shamilajeewantha/fluid-pendant/specs/001-multi-stage-fluid-sim/checklists/requirements.md

# Specification Quality Checklist: Multi-Stage Fluid Simulation Pendant

**Purpose**: Validate specification completeness and quality before proceeding to planning
**Created**: 2026-06-21
**Feature**: [spec.md](../spec.md)

## Content Quality

- [x] No implementation details (languages, frameworks, APIs)
- [x] Focused on user value and business needs
- [x] Written for non-technical stakeholders
- [x] All mandatory sections completed

## Requirement Completeness

- [x] No [NEEDS CLARIFICATION] markers remain
- [x] Requirements are testable and unambiguous
- [x] Success criteria are measurable
- [x] Success criteria are technology-agnostic (no implementation details)
- [x] All acceptance scenarios are defined
- [x] Edge cases are identified
- [x] Scope is clearly bounded
- [x] Dependencies and assumptions identified

## Feature Readiness

- [x] All functional requirements have clear acceptance criteria
- [x] User scenarios cover primary flows
- [x] Feature meets measurable outcomes defined in Success Criteria
- [x] No implementation details leak into specification

## Notes

- Items marked incomplete require spec updates before `/speckit-clarify` or `/speckit-plan`.
- No [NEEDS CLARIFICATION] markers were needed: the project's existing constitution (`.specify/memory/constitution.md`) and prior codebase (existing C simulation source, existing accelerometer/LED-matrix sample projects) already fix the hardware-level facts (target MCU, accelerometer, charlieplexed display) that would otherwise require clarification. Reasonable defaults for remaining ambiguities are documented in the Assumptions section.
