shamilajeewantha/fluid-pendant/media/photos/altium/pcb_3d_angled.png

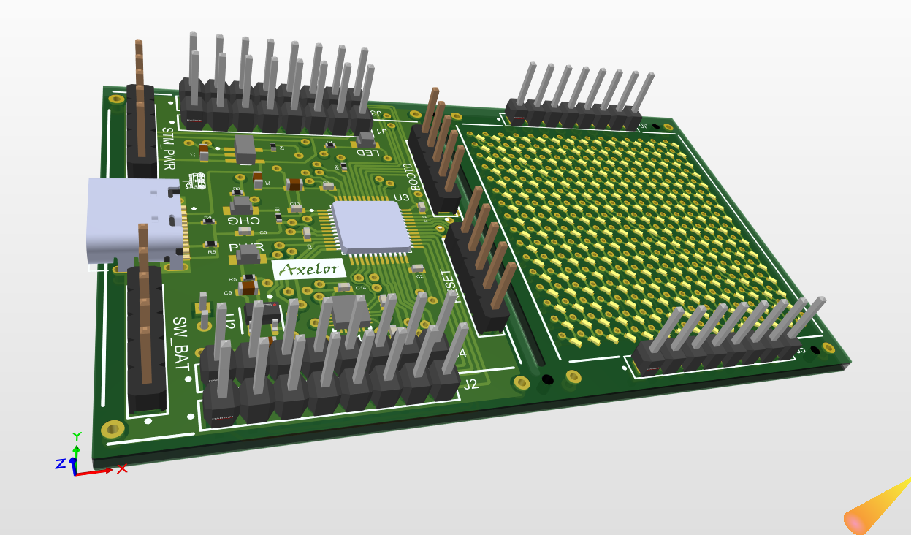
media/photos/altium/pcb_3d_angled.png
