shamilajeewantha/fluid-pendant/media/photos/pcb/axelor5.jpg

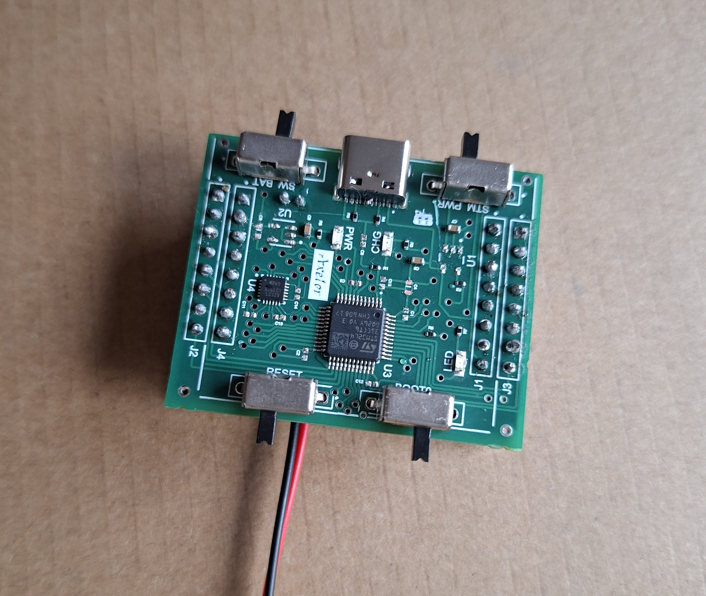
media/photos/pcb/axelor5.jpg
