shamilajeewantha/fluid-pendant/media/photos/pcb/axelor6.jpg

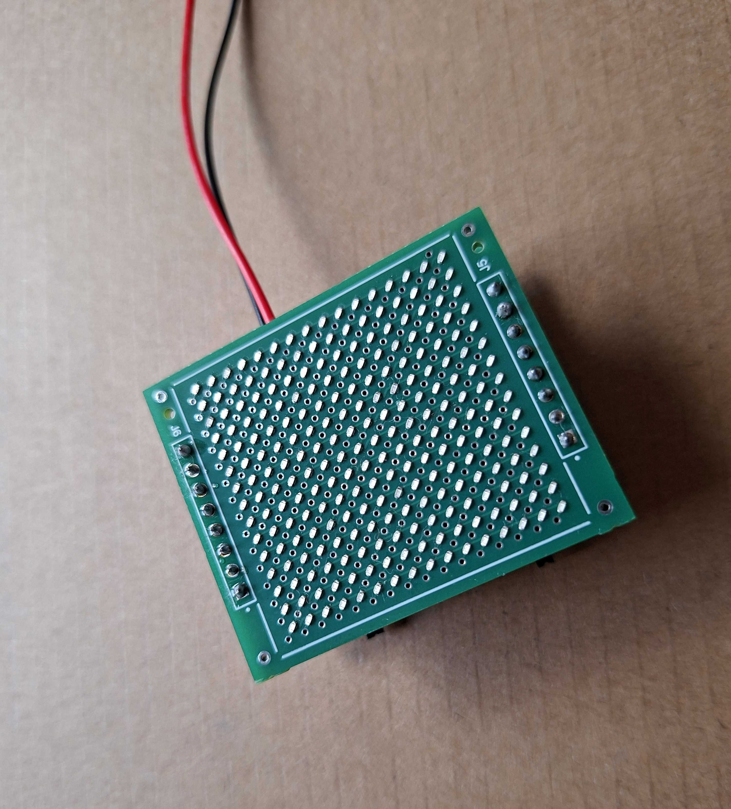
media/photos/pcb/axelor6.jpg
