shamilajeewantha/fluid-pendant/media/photos/pcb/axelor8.jpg

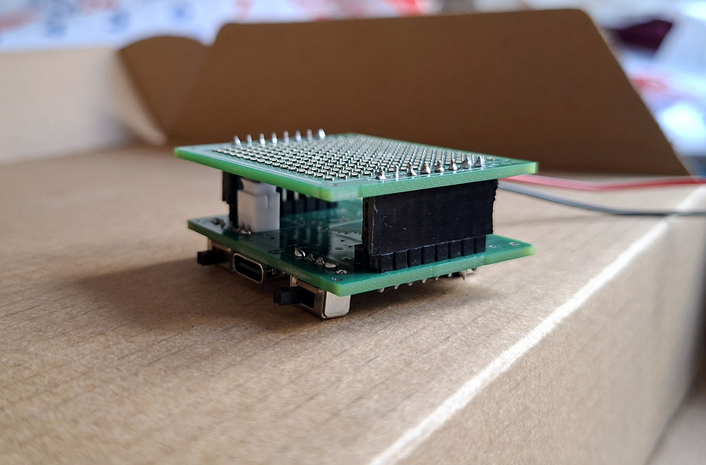
media/photos/pcb/axelor8.jpg
