shamilajeewantha/fluid-pendant/media/photos/pcb/axelor10.jpg

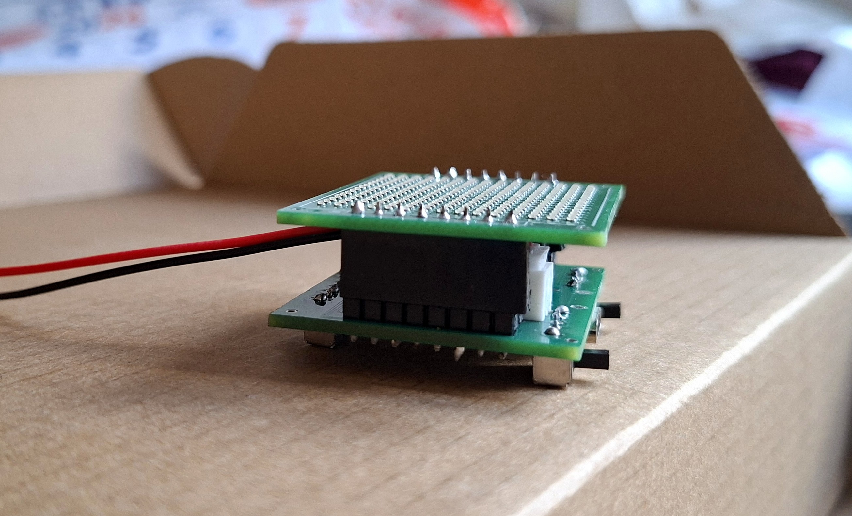
media/photos/pcb/axelor10.jpg
