shamilajeewantha/fluid-pendant/media/photos/pcb/axelor11.jpg

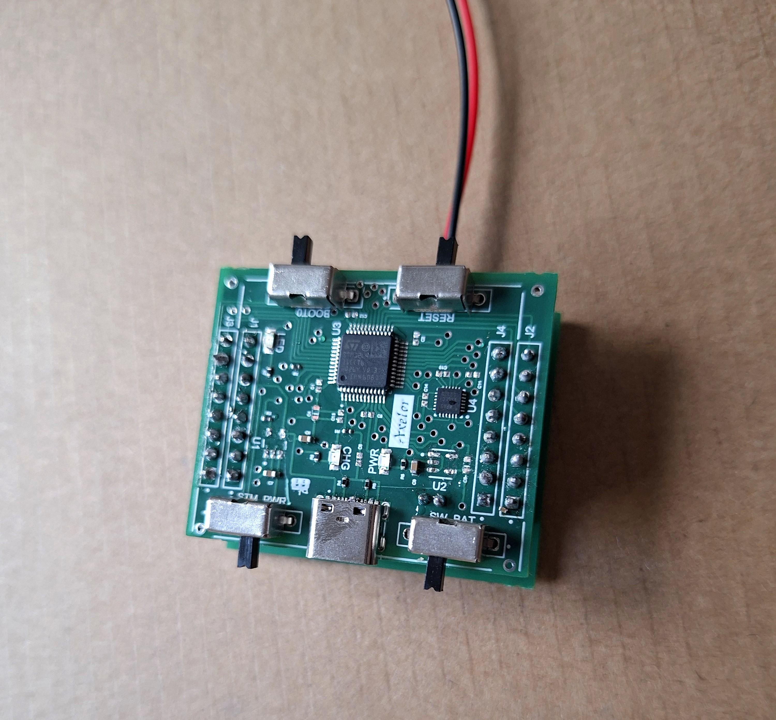
media/photos/pcb/axelor11.jpg
