shamilajeewantha/fluid-pendant/media/photos/pcb/axelor12.jpg

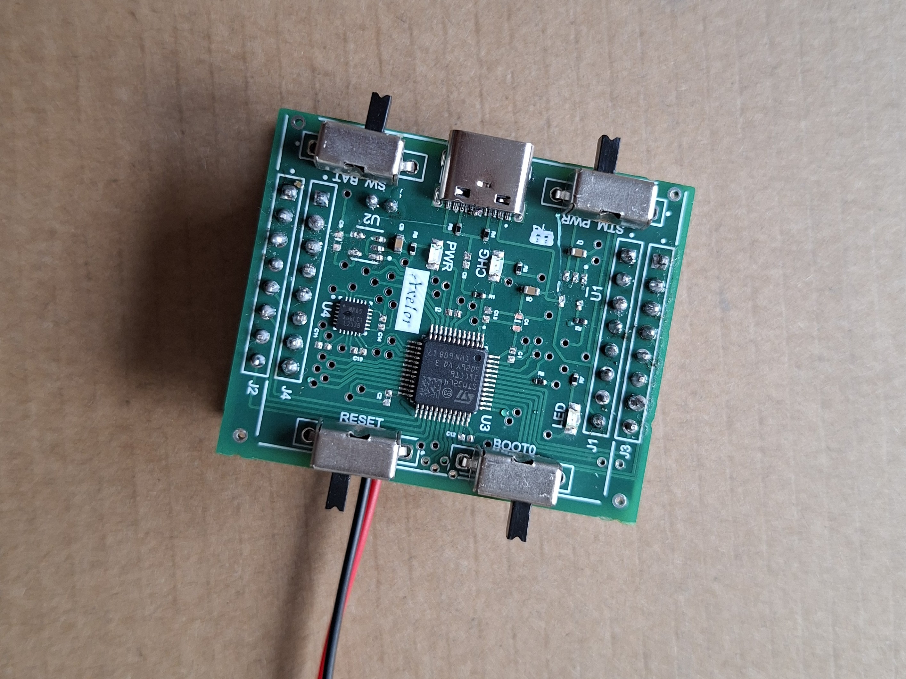
media/photos/pcb/axelor12.jpg
