shamilajeewantha/fluid-pendant/media/photos/pcb/axelor13.jpg

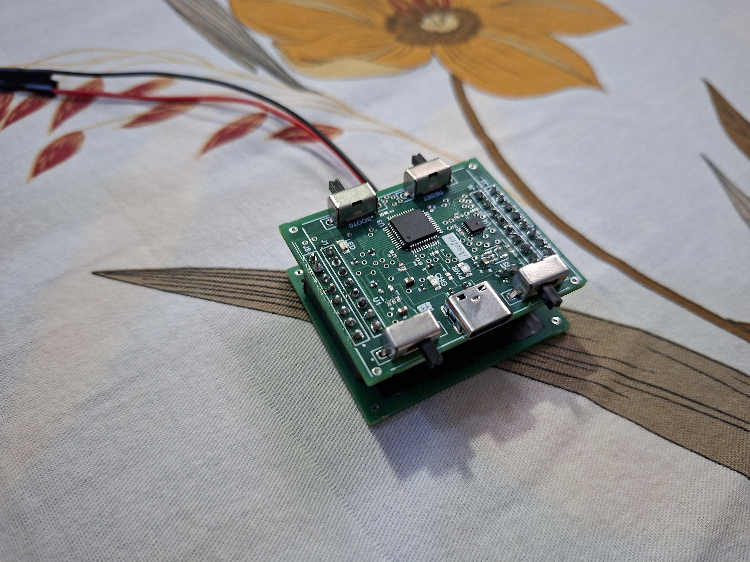
media/photos/pcb/axelor13.jpg
