shamilajeewantha/fluid-pendant/media/photos/pcb/loose_connections.jpg

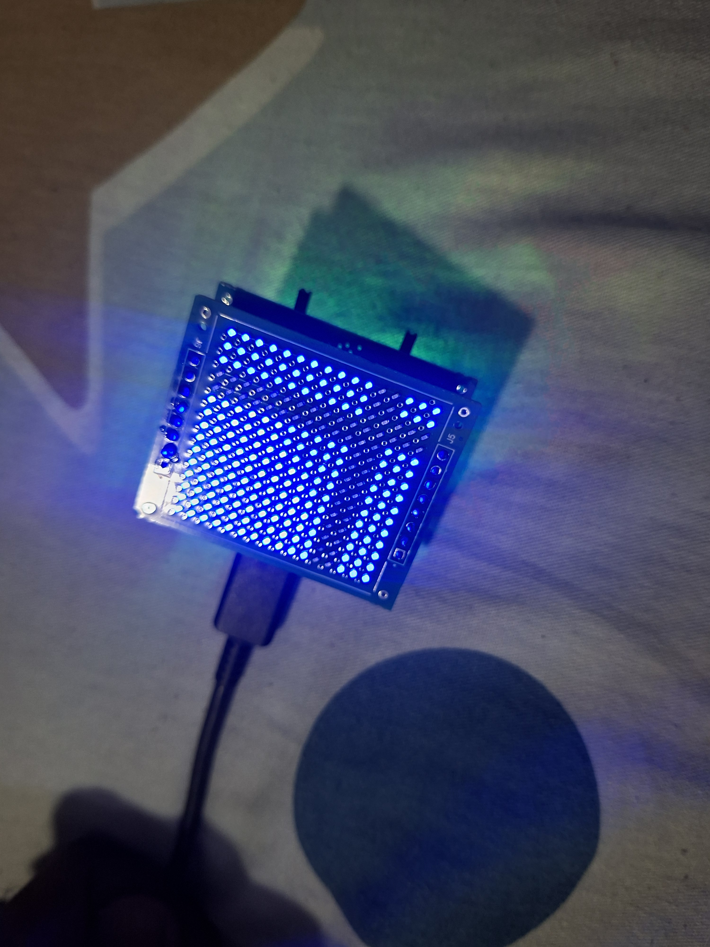
media/photos/pcb/loose_connections.jpg
