shamilajeewantha/fluid-pendant/media/photos/pcb/two_pieces.jpg

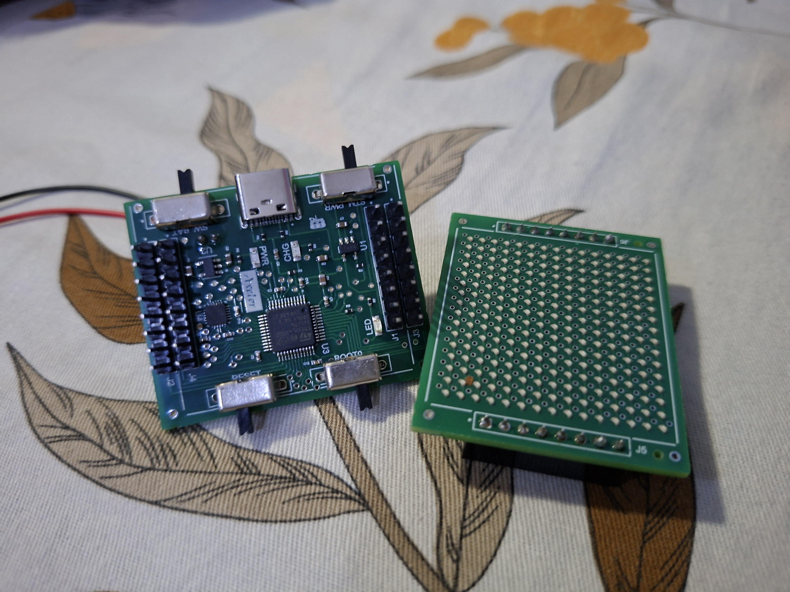
media/photos/pcb/two_pieces.jpg
