shamilajeewantha/fluid-pendant/stm_project/axelor/Core/Src/main.c

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
/* Includes ------------------------------------------------------------------*/
#include "main.h"

/* USER CODE BEGIN Includes */
#include <stdio.h>
#include <string.h>
#include "scene.h"
#include "flip_utils.h"
/* USER CODE END Includes */

SPI_HandleTypeDef hspi1;

TIM_HandleTypeDef htim1;
DMA_HandleTypeDef hdma_tim1_up;
DMA_HandleTypeDef hdma_tim1_ch1;

UART_HandleTypeDef huart1;

/* USER CODE BEGIN PV */

uint32_t blinkCounter = 0;
char msg[128];

/* Charlieplex hardware bring-up scan. This board has NO per-leg current-limiting
   resistors on PB0..PB15 (confirmed), so the only thing protecting the GPIO pins
   from a software bug is the software itself -- see ChargePlex_ValidateScanTable
   and ChargePlex_CheckAlive below. */
#define CP_PIN_COUNT  16
#define CP_SLOT_COUNT (CP_PIN_COUNT * (CP_PIN_COUNT - 1)) /* 240: every ordered (src,dst) pin pair */

/* This board's wiring (confirmed by user): each of the 16 PB pins takes a turn as one row's
   single source/driving pin, with the other 15 pins as that row's sink/column pins -- the
   standard charlieplex row/column convention. ChargePlex_BuildScanTable's enumeration order
   (outer loop over src, inner loop over dst) already groups slots into exactly CP_ROWS
   contiguous blocks of CP_COLS slots each as a direct result -- row r occupies slots
   [r*CP_COLS, r*CP_COLS + CP_COLS - 1]. */
#define CP_ROWS CP_PIN_COUNT       /* 16 */
#define CP_COLS (CP_PIN_COUNT - 1) /* 15 */

static uint32_t bsrr_buf[CP_SLOT_COUNT];
static uint32_t moder_buf[CP_SLOT_COUNT];
static volatile uint8_t chargePlexFaulted = 0;
static uint8_t chargePlexFaultReported = 0;

/* Set true only after HAL_DMA_Start has actually run on both channels in main(), below.
   SysTick (and therefore ChargePlex_CheckAlive, which it calls every 1ms) starts running at
   HAL_Init(), several peripheral inits before MX_TIM1_Init() gives hdma_tim1_up/ch1 a real
   .Instance (set inside HAL_TIM_Base_MspInit, stm32l4xx_hal_msp.c). Without this guard,
   ChargePlex_CheckAlive reads __HAL_DMA_GET_COUNTER on a NULL .Instance during that gap --
   garbage memory, not a real transfer counter -- and a false "stalled" reading there
   permanently latches chargePlexFaulted before the real scan table even exists, silently
   disabling this watchdog for the rest of the session. */
static volatile uint8_t chargePlexScanStarted = 0;

/* Immutable per-slot "this is what moder_buf[slot] would be if this slot is on" reference,
   filled once by ChargePlex_BuildScanTable and never modified afterward -- moder_buf itself
   gets zeroed for "off" slots every frame, so this is what lets a slot be safely turned back
   on later without losing its source/sink pin-pair identity. */
static uint32_t moder_template[CP_SLOT_COUNT];

/* Firmware-local stand-in for DisplayFrame/cellColor until the physics core is ported
   onto this board (research.md Decision 17, data-model.md AxelorFrameBuffer). Shaped as an
   actual [row][col] matrix (not a flat 240 array) to match the eventual real DisplayFrame/
   cellColor shape directly -- no flattening will be needed when that swap happens. Filled by
   a placeholder pattern generator for now; NOT read by DMA -- only ChargePlex_ApplyFrameBuffer()
   translates it into moder_buf (via the row/col -> slot formula above), and only after
   re-validating. The DMA scanner, bsrr_buf, moder_template, and the validator are untouched by
   this -- this buffer is purely upstream of ChargePlex_ApplyFrameBuffer's existing gate. */
static uint8_t cpFrameBuf[CP_ROWS][CP_COLS];
static uint32_t cpCandidateModer[CP_SLOT_COUNT];

/* Round 9: the real ported FLIP simulation driving cpFrameBuf above, in place of Round 8's
   placeholder pattern generator (research.md Decisions 21-24). */
static Scene axelorScene;

/* MPU-6500's own +/-2g full-scale range (spec.md Clarifications Session 2026-06-23;
   research.md Decision 22) -- clamps accelX_mps2/accelY_mps2 before they reach
   simulateFlipFluid, so a violent shake can't inject an unbounded force into the solver. */
#define MAX_GRAVITY_MPS2 19.62f

static inline float ClampGravityMps2(float v)
{
    if (v > MAX_GRAVITY_MPS2) return MAX_GRAVITY_MPS2;
    if (v < -MAX_GRAVITY_MPS2) return -MAX_GRAVITY_MPS2;
    return v;
}

/* Round 11: dt is now this tick's measured wall-clock time (HAL_GetTick(), 1ms resolution), not a
   fixed 0.02f -- the loop no longer sleeps a fixed amount, so a fixed dt would drift from real
   time by whatever the tick's compute happened to cost (research.md Round 11). Clamped so the
   solver stays stable if a tick stalls, and to avoid dt<=0 if two ticks land in the same ms. */
#define MIN_DT_S 0.001f
#define MAX_DT_S 0.04f

static inline float ClampDtS(float v)
{
    if (v < MIN_DT_S) return MIN_DT_S;
    if (v > MAX_DT_S) return MAX_DT_S;
    return v;
}

/* Shared by the Counter print and MPU6500_ReadAccel's own prints below. Round 11: switched from
   iteration-count throttling (printTick % 25, tuned for the old fixed ~20ms/iteration) to
   elapsed-time throttling, since the loop no longer has a fixed period -- recomputed once per
   loop iteration, before MPU6500_ReadAccel() is called. */
static uint32_t lastPrintMs = 0;
static uint8_t printGate = 0;

/* USER CODE END PV */

void SystemClock_Config(void);
static void MX_GPIO_Init(void);
static void MX_DMA_Init(void);
static void MX_SPI1_Init(void);
static void MX_USART1_UART_Init(void);
static void MX_TIM1_Init(void);
/* USER CODE BEGIN 0 */

/* Retargets newlib's printf to huart1. Without this, syscalls.c's _write falls through to a
   weak, undefined __io_putchar -- harmless as long as nothing calls printf, but flip_utils.c's
   setupScene() (ported as-is from the canonical physics source, research.md Decision 18) does
   call printf once at boot, which would otherwise jump to an unresolved address and HardFault
   the very first time the simulation is set up. */
int __io_putchar(int ch)
{
    HAL_UART_Transmit(&huart1, (uint8_t*)&ch, 1, HAL_MAX_DELAY);
    return ch;
}

uint8_t mpuTxData[2];
uint8_t mpuRxData[2];

void MPU6500_ReadWhoAmI(void)
{
    uint8_t whoami;
    HAL_StatusTypeDef status;

    sprintf(msg, "[MPU] Starting WHO_AM_I read...\r\n");
    HAL_UART_Transmit(&huart1, (uint8_t*)msg, strlen(msg), HAL_MAX_DELAY);

    sprintf(msg, "[MPU] CS (PA5) -> LOW\r\n");
    HAL_UART_Transmit(&huart1, (uint8_t*)msg, strlen(msg), HAL_MAX_DELAY);
    HAL_GPIO_WritePin(GPIOA, GPIO_PIN_5, GPIO_PIN_RESET); // CS low

    mpuTxData[0] = 0x75 | 0x80; // WHO_AM_I register (0x75), read bit set
    mpuTxData[1] = 0x00;        // dummy byte to receive data

    status = HAL_SPI_TransmitReceive(&hspi1, mpuTxData, mpuRxData, 2, HAL_MAX_DELAY);

    HAL_GPIO_WritePin(GPIOA, GPIO_PIN_5, GPIO_PIN_SET); // CS high

    /* Snapshot results immediately, before any sprintf can touch these buffers */
    uint8_t tx0 = mpuTxData[0], tx1 = mpuTxData[1];
    uint8_t rx0 = mpuRxData[0], rx1 = mpuRxData[1];
    whoami = rx1;

    sprintf(msg, "[MPU] CS (PA5) -> HIGH\r\n");
    HAL_UART_Transmit(&huart1, (uint8_t*)msg, strlen(msg), HAL_MAX_DELAY);

    sprintf(msg, "[MPU] HAL_SPI_TransmitReceive status: %d (0=OK,1=ERROR,2=BUSY,3=TIMEOUT)\r\n", status);
    HAL_UART_Transmit(&huart1, (uint8_t*)msg, strlen(msg), HAL_MAX_DELAY);

    sprintf(msg, "[MPU] tx=[0x%02X 0x%02X] rx=[0x%02X 0x%02X]\r\n", tx0, tx1, rx0, rx1);
    HAL_UART_Transmit(&huart1, (uint8_t*)msg, strlen(msg), HAL_MAX_DELAY);

    sprintf(msg, "[MPU] WHO_AM_I: 0x%02X (expect 0x70) -> %s\r\n",
            whoami, (whoami == 0x70) ? "PASS" : "FAIL");
    HAL_UART_Transmit(&huart1, (uint8_t*)msg, strlen(msg), HAL_MAX_DELAY);
}

void MPU6500_WriteReg(uint8_t reg, uint8_t value)
{
    uint8_t tx[2] = { (uint8_t)(reg & 0x7F), value }; // write: MSB of addr = 0
    uint8_t rx[2];

    HAL_GPIO_WritePin(GPIOA, GPIO_PIN_5, GPIO_PIN_RESET);
    HAL_SPI_TransmitReceive(&hspi1, tx, rx, 2, HAL_MAX_DELAY);
    HAL_GPIO_WritePin(GPIOA, GPIO_PIN_5, GPIO_PIN_SET);
}

void MPU6500_ReadRegs(uint8_t reg, uint8_t *buf, uint8_t len)
{
    uint8_t tx[8] = {0};
    uint8_t rx[8] = {0};

    tx[0] = reg | 0x80; // read: MSB of addr = 1

    HAL_GPIO_WritePin(GPIOA, GPIO_PIN_5, GPIO_PIN_RESET);
    HAL_SPI_TransmitReceive(&hspi1, tx, rx, len + 1, HAL_MAX_DELAY);
    HAL_GPIO_WritePin(GPIOA, GPIO_PIN_5, GPIO_PIN_SET);

    memcpy(buf, &rx[1], len);
}

void MPU6500_Init(void)
{
    MPU6500_WriteReg(0x6A, 0x10); // USER_CTRL: I2C_IF_DIS = 1, lock to SPI-only mode
    HAL_Delay(1);
    MPU6500_WriteReg(0x6B, 0x01); // PWR_MGMT_1: clear SLEEP, select PLL clock source
    HAL_Delay(10);
    MPU6500_WriteReg(0x1C, 0x00); // ACCEL_CONFIG: AFS_SEL = 0 -> +/-2g, 16384 LSB/g

    sprintf(msg, "[MPU] Init done: SPI-only, awake, accel range +/-2g\r\n");
    HAL_UART_Transmit(&huart1, (uint8_t*)msg, strlen(msg), HAL_MAX_DELAY);
}

uint8_t accelRaw[6];
int16_t accelX_raw, accelY_raw, accelZ_raw;
/* Round 9: promoted from MPU6500_ReadAccel's locals to file scope so main()'s loop can read
   this tick's value as the simulation's gravity input after this function returns (research.md
   Decision 16/22). */
float accelX_mps2, accelY_mps2, accelZ_mps2;

void MPU6500_ReadAccel(void)
{
    MPU6500_ReadRegs(0x3B, accelRaw, 6); // ACCEL_XOUT_H..ACCEL_ZOUT_L

    accelX_raw = (int16_t)((accelRaw[0] << 8) | accelRaw[1]);
    accelY_raw = (int16_t)((accelRaw[2] << 8) | accelRaw[3]);
    accelZ_raw = (int16_t)((accelRaw[4] << 8) | accelRaw[5]);

    // milli-g via integer math (avoids needing float-in-printf support)
    long accelX_mg = ((long)accelX_raw * 1000) / 16384;
    long accelY_mg = ((long)accelY_raw * 1000) / 16384;
    long accelZ_mg = ((long)accelZ_raw * 1000) / 16384;

    if (printGate)
    {
        sprintf(msg, "[ACCEL] raw=[%d %d %d] mg=[%ld %ld %ld]\r\n",
                accelX_raw, accelY_raw, accelZ_raw, accelX_mg, accelY_mg, accelZ_mg);
        HAL_UART_Transmit(&huart1, (uint8_t*)msg, strlen(msg), HAL_MAX_DELAY);
    }

    // m/s^2 -- the exact unit/scale MotionInput.x/y and Scene.gravity_x/y need (research.md
    // Decision 16). Round 9: this now IS read, as the simulation's gravity input (clamped in
    // main()'s loop before reaching simulateFlipFluid, research.md Decision 22).
    accelX_mps2 = (accelX_mg / 1000.0f) * 9.81f;
    accelY_mps2 = (accelY_mg / 1000.0f) * 9.81f;
    accelZ_mps2 = (accelZ_mg / 1000.0f) * 9.81f;

    if (printGate)
    {
        // Printed as milli-(m/s^2) integers, same float-in-printf avoidance as the mg line above --
        // the underlying accel*_mps2 floats are the real value driving the simulation; only the
        // *display* stays integer-only.
        long accelX_mmps2 = (long)(accelX_mps2 * 1000.0f);
        long accelY_mmps2 = (long)(accelY_mps2 * 1000.0f);
        long accelZ_mmps2 = (long)(accelZ_mps2 * 1000.0f);

        sprintf(msg, "[ACCEL] mm/s2=[%ld %ld %ld] (= m/s2 x1000; sim will want this unit/scale)\r\n",
                accelX_mmps2, accelY_mmps2, accelZ_mmps2);
        HAL_UART_Transmit(&huart1, (uint8_t*)msg, strlen(msg), HAL_MAX_DELAY);
    }
}

/* Fills bsrr_buf/moder_buf with every one of the 240 ordered (source,sink) pin
   pairs on PB0..PB15, generated from the charlieplex formula instead of hand-typed
   hex -- a transcription error in a 240-entry literal table is exactly the kind of
   mistake that, on this resistor-less board, could drive two pins into each other.
   Bit-pattern verified by hand against the working 3-pin proof of concept in
   stm_projects/sample-charlieplexing (e.g. its LED1 = PB0 source/PB6 sink encodes
   to moder=0x00001001/bsrr=0x00400001, which this formula reproduces exactly for
   src=0,dst=6). */
static void ChargePlex_BuildScanTable(void)
{
    int slot = 0;
    for (int src = 0; src < CP_PIN_COUNT; src++)
    {
        for (int dst = 0; dst < CP_PIN_COUNT; dst++)
        {
            if (src == dst) continue;
            bsrr_buf[slot]      = (1UL << src) | (1UL << (dst + 16));
            moder_template[slot] = (1UL << (src * 2)) | (1UL << (dst * 2));
            moder_buf[slot]      = moder_template[slot]; /* initial state: every slot on */
            slot++;
        }
    }
}

/* Confirms every one of the 240 slots is either a valid "on" slot (exactly one source
   pin high, one different sink pin low, every other pin plain input) or a valid "off"
   slot (every pin plain input, nothing driven) -- checked before MOE/DMA are ever
   enabled, and again before any regenerated frame buffer is allowed to replace the
   live moder_buf (research.md Decision 17), so a table bug fails safe (matrix doesn't
   start, or the previous known-good frame is kept) instead of silently energizing an
   unintended pin pair. */
static int ChargePlex_ValidateScanTable(const uint32_t *moderToCheck)
{
    for (int slot = 0; slot < CP_SLOT_COUNT; slot++)
    {
        uint32_t moder = moderToCheck[slot];
        uint32_t bsrr  = bsrr_buf[slot]; /* bsrr_buf never changes after boot -- only moder does */
        int outputCount = 0;
        int srcPin = -1, dstPin = -1;

        for (int pin = 0; pin < CP_PIN_COUNT; pin++)
        {
            uint32_t field  = (moder >> (pin * 2)) & 0x3UL;
            int      isSet  = (bsrr & (1UL << pin)) != 0;
            int      isReset = (bsrr & (1UL << (pin + 16))) != 0;

            if (field == 0x1) /* configured as output for this slot */
            {
                outputCount++;
                if (isReset)    dstPin = pin; /* RESET has priority over SET in BSRR on real silicon */
                else if (isSet) srcPin = pin;
                else            return 0; /* output pin with no defined level -- reject */
            }
            else if (field != 0x0)
            {
                return 0; /* AF/analog should never appear in this table -- reject */
            }
            /* field == 0x0 (input): nothing to check. bsrr_buf is immutable and permanently
               holds this slot's 2 designated pins regardless of whether this slot is currently
               on or off -- an input pin is electrically disconnected from BSRR/ODR at the
               hardware level, so a "set"/"reset" bit sitting there for an off slot is the
               expected, harmless resting state, not a defect (this was incorrectly rejected
               before Round 8's off-slot support was added, which made every off slot fail). */
        }

        if (outputCount == 0)
        {
            continue; /* valid "off" slot -- nothing driven this cycle (research.md Decision 17) */
        }
        if (outputCount != 2 || srcPin < 0 || dstPin < 0 || srcPin == dstPin)
            return 0;
    }
    return 1;
}

/* Translates cpFrameBuf into a candidate moder_buf (on slots get their immutable
   moder_template pattern back; off slots get 0/all-input), validates that candidate in
   full, and only then commits it over the live moder_buf -- exactly the same fail-safe
   shape as the boot-time check, applied to every regenerated frame (research.md Decision
   17). A rejected frame is not a stall (the existing scan is still known-good and keeps
   running); it just means this particular new frame didn't pass and is discarded. */
static void ChargePlex_ApplyFrameBuffer(void)
{
    for (int row = 0; row < CP_ROWS; row++)
    {
        for (int col = 0; col < CP_COLS; col++)
        {
            int slot = row * CP_COLS + col; /* matches ChargePlex_BuildScanTable's row-major (src,dst) enumeration exactly */
            cpCandidateModer[slot] = cpFrameBuf[row][col] ? moder_template[slot] : 0;
        }
    }

    if (ChargePlex_ValidateScanTable(cpCandidateModer))
    {
        memcpy(moder_buf, cpCandidateModer, sizeof(moder_buf));
    }
    else
    {
        sprintf(msg, "[CHARLIEPLEX] frame rejected, keeping previous frame\r\n");
        HAL_UART_Transmit(&huart1, (uint8_t*)msg, strlen(msg), HAL_MAX_DELAY);
    }
}

/* Drives every PB pin back to plain input (HiZ) directly via register write,
   bypassing TIM1/DMA entirely. Deliberately avoids any HAL call that polls against
   HAL_GetTick() (e.g. HAL_DMA_Abort) -- this can be invoked from SysTick_Handler
   itself, where the tick is not advancing, so any such call would spin forever
   instead of completing. */
static void ChargePlex_ForceSafeState(void)
{
    __HAL_TIM_MOE_DISABLE(&htim1);
    __HAL_TIM_DISABLE(&htim1);
    hdma_tim1_up.Instance->CCR  &= ~DMA_CCR_EN;
    hdma_tim1_ch1.Instance->CCR &= ~DMA_CCR_EN;
    GPIOB->MODER = 0x00000000;
}

/* Called every 1ms from SysTick_Handler (stm32l4xx_it.c) so stall-detection latency
   never depends on whatever the main loop happens to be blocked in (HAL_Delay,
   blocking UART/SPI transfers, etc). Compares each DMA channel's remaining-transfer
   counter against the value read on the *previous* 1ms tick: at the real scan rate
   (~80MHz/2776 =~ 28.8 kHz/slot) the counter advances by roughly 28 of its 240
   states every millisecond, so an unchanged reading one tick later means the scan
   has stalled -- and with no series resistors on this board, a stalled scan means
   whatever pin pair was active is now driven continuously instead of multiplexed. */
void ChargePlex_CheckAlive(void)
{
    static uint32_t lastUp  = 0xFFFFFFFFUL; /* sentinel: no prior sample yet */
    static uint32_t lastCh1 = 0xFFFFFFFFUL;

    if (chargePlexFaulted || !chargePlexScanStarted) return;

    uint32_t up  = __HAL_DMA_GET_COUNTER(&hdma_tim1_up);
    uint32_t ch1 = __HAL_DMA_GET_COUNTER(&hdma_tim1_ch1);

    if (lastUp != 0xFFFFFFFFUL && (up == lastUp || ch1 == lastCh1))
    {
        chargePlexFaulted = 1;
        ChargePlex_ForceSafeState();
    }

    lastUp  = up;
    lastCh1 = ch1;
}
/* USER CODE END 0 */

/**
  * @brief  The application entry point.
  * @retval int
  */
int main(void)
{

  /* MCU Configuration--------------------------------------------------------*/

  /* Reset of all peripherals, Initializes the Flash interface and the Systick. */
  HAL_Init();

  /* Configure the system clock */
  SystemClock_Config();

  /* Initialize all configured peripherals */
  MX_GPIO_Init();
  MX_DMA_Init();
  MX_SPI1_Init();
  MX_USART1_UART_Init();
  MX_TIM1_Init();
  /* USER CODE BEGIN 2 */
  sprintf(msg, "\r\n>>> BUILD MARKER: AXELOR-001 <<<\r\n");
  HAL_UART_Transmit(&huart1, (uint8_t*)msg, strlen(msg), HAL_MAX_DELAY);

  HAL_Delay(100); // MPU-6500 register read/write start-up time
  MPU6500_ReadWhoAmI();
  MPU6500_Init();

  /* Round 9: bring up the real ported FLIP simulation before the matrix scan starts, so
     cpFrameBuf is never read by ChargePlex_ApplyFrameBuffer before it has real sim output to
     copy (research.md Decision 24). scene_init()/setupScene() are the unmodified, ported
     functions; paused is forced false only here, in this board-specific glue code -- there is
     no UI on this board to ever un-pause it otherwise. */
  scene_init(&axelorScene);
  setupScene(&axelorScene);
  axelorScene.paused = false;
  sprintf(msg, "[SIM] setup complete\r\n");
  HAL_UART_Transmit(&huart1, (uint8_t*)msg, strlen(msg), HAL_MAX_DELAY);

  ChargePlex_BuildScanTable();
  if (!ChargePlex_ValidateScanTable(moder_buf))
  {
      sprintf(msg, "[CHARLIEPLEX] FAULT: scan table failed self-check -- matrix NOT started\r\n");
      HAL_UART_Transmit(&huart1, (uint8_t*)msg, strlen(msg), HAL_MAX_DELAY);
      chargePlexFaulted = 1;
      chargePlexFaultReported = 1;
      ChargePlex_ForceSafeState(); /* belt-and-suspenders: PB pins should already be input from MX_GPIO_Init */
  }
  else
  {
      sprintf(msg, "[CHARLIEPLEX] scan table OK (240/240 slots), starting matrix scan\r\n");
      HAL_UART_Transmit(&huart1, (uint8_t*)msg, strlen(msg), HAL_MAX_DELAY);

      __HAL_TIM_MOE_ENABLE(&htim1);
      HAL_DMA_Start(&hdma_tim1_ch1, (uint32_t)bsrr_buf, (uint32_t)&GPIOB->BSRR, CP_SLOT_COUNT);
      HAL_DMA_Start(&hdma_tim1_up, (uint32_t)moder_buf, (uint32_t)&GPIOB->MODER, CP_SLOT_COUNT);
      HAL_TIM_OC_Start(&htim1, TIM_CHANNEL_1);
      __HAL_TIM_ENABLE_DMA(&htim1, TIM_DMA_CC1);
      __HAL_TIM_ENABLE_DMA(&htim1, TIM_DMA_UPDATE);
      HAL_TIM_Base_Start(&htim1);
      chargePlexScanStarted = 1; /* only now is it safe for ChargePlex_CheckAlive to read the DMA counters */
  }
  /* USER CODE END 2 */

  /* Round 11: tracks real elapsed time between ticks so dt can be measured instead of assumed
     (research.md Round 11). Initialized right before the loop starts, not at declaration, so the
     first iteration's delta is near-zero rather than however long boot took. */
  uint32_t lastTickMs = HAL_GetTick();

  /* Infinite loop */
  /* USER CODE BEGIN WHILE */
  while (1)
  {
    /* USER CODE END WHILE */

    /* USER CODE BEGIN 3 */
    /* Round 11: one HAL_GetTick() read serves both this tick's dt and the print-throttle gate --
       the loop no longer sleeps a fixed amount, so both must be measured, not assumed. */
    uint32_t nowMs = HAL_GetTick();
    float tickDt = ClampDtS((nowMs - lastTickMs) / 1000.0f);
    lastTickMs = nowMs;
    printGate = (nowMs - lastPrintMs) >= 500;
    if (printGate) lastPrintMs = nowMs;

    /* Read first so this tick's freshest accel sample drives this tick's simulation step
       below, rather than the previous tick's (research.md Decision 21/22). */
    MPU6500_ReadAccel();

    if (chargePlexFaulted && !chargePlexFaultReported)
    {
        sprintf(msg, "[CHARLIEPLEX] FAULT: scan stalled -- matrix forced to safe input state\r\n");
        HAL_UART_Transmit(&huart1, (uint8_t*)msg, strlen(msg), HAL_MAX_DELAY);
        chargePlexFaultReported = 1;
    }
    else if (!chargePlexFaulted)
    {
        /* Round 9: the real ported simulation replaces Round 8's placeholder pattern
           generator (research.md Decision 23). Gravity input is this tick's accel reading,
           magnitude-clamped to the MPU-6500's own +/-2g range (Decision 22) before reaching
           simulateFlipFluid -- the physics core itself stays an unmodified, verbatim port
           (contracts/physics-core.md), so the clamp lives here in board-specific glue code.
           Round 10: on-hardware testing found the board's mounted accelerometer axes are
           swapped relative to the display's row/col axes -- accelX_mps2 is physically the
           vertical (row) axis and accelY_mps2 is the horizontal (col) axis, not the other way
           around as originally assumed. gravity_y drives row motion and gravity_x drives col
           motion in simulateFlipFluid (see flip_fluid.c's dstY*GRID_X+dstX convention), so the
           accel axes are swapped here to match. */
        float clampedGravityX = ClampGravityMps2(accelY_mps2);
        float clampedGravityY = ClampGravityMps2(accelX_mps2);

        simulateFlipFluid(axelorScene.fluid, tickDt, clampedGravityX, clampedGravityY,
                           axelorScene.flipRatio, axelorScene.numPressureIters,
                           axelorScene.numParticleIters, axelorScene.overRelaxation,
                           axelorScene.compensateDrift, axelorScene.separateParticles);

        for (int row = 0; row < CP_ROWS; row++)
        {
            for (int col = 0; col < CP_COLS; col++)
            {
                cpFrameBuf[row][col] = (axelorScene.fluid->cellColor[row * GRID_X + col] > 0.5f) ? 1 : 0;
            }
        }

        /* Unmodified from Round 8 -- still the same validate-or-reject gate, applied to the
           real simulation's output exactly as it was to the placeholder pattern. */
        ChargePlex_ApplyFrameBuffer();
    }

    HAL_GPIO_TogglePin(GPIOC, GPIO_PIN_13);
    blinkCounter++;
    if (printGate)
    {
        sprintf(msg, "Counter: %lu\r\n", blinkCounter);
        HAL_UART_Transmit(&huart1, (uint8_t*)msg, strlen(msg), HAL_MAX_DELAY);
    }
    /* Round 11: no fixed delay -- loop runs at compute speed (research.md Round 11). Safe because
       ChargePlex's scan is TIM1+DMA-driven, decoupled from main-loop rate; this never changes
       what's written to cpFrameBuf or how often ChargePlex_ApplyFrameBuffer() is called per tick. */
  }
  /* USER CODE END 3 */
}

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
