shamilajeewantha/fluid-pendant/stm_project/axelor/axelor.ioc

Mcu.UserName=STM32L431CCTx
PA1.Signal=SPI1_SCK
PA10.Signal=USART1_RX
PA5.Signal=GPIO_Output
PA6.Signal=SPI1_MISO
PA7.Signal=SPI1_MOSI
PA9.Signal=USART1_TX
PB0.Signal=GPIO_Input
PB1.Signal=GPIO_Input
PB10.Signal=GPIO_Input
PB11.Signal=GPIO_Input
PB12.Signal=GPIO_Input
PB13.Signal=GPIO_Input
PB14.Signal=GPIO_Input
PB15.Signal=GPIO_Input
PB2.Signal=GPIO_Input
PB5.Signal=GPIO_Input
PB6.Signal=GPIO_Input
PB7.Signal=GPIO_Input
PB8.Signal=GPIO_Input
PB9.Signal=GPIO_Input
PC13.Signal=GPIO_Output
