shamilajeewantha/fluid-pendant/stm_project/axelor/Core/Inc/flip_fluid.h

#ifndef FLIP_FLUID_H
#define FLIP_FLUID_H

// Display grid resolution: 1:1 with the 16-row x 15-column charlieplexed LED matrix.
#define GRID_X 15  // columns
#define GRID_Y 16  // rows

// The solver's own internal grid is padded one cell beyond the display on every walled
// side (left, right, bottom — see flip_utils.c's setupScene() wall setup), so those
// structurally-solid wall cells fall outside the visible GRID_X x GRID_Y window instead
// of being its outermost ring (which would otherwise make those display cells permanently
// unable to show fluid, since wall cells never become FLUID_CELL). The top has no wall,
// so it isn't padded. See research.md Decision 7.
#define PAD_FNUM_X (GRID_X + 2)
#define PAD_FNUM_Y (GRID_Y + 1)

// Round 9 (axelor only): static-allocation maxima replacing the original malloc/calloc
// sizing (research.md Decision 19) — this board has no heap, and this project has exactly
// one fixed tank configuration, so these are the literal results of setupScene()'s own
// formulas for that configuration, not arbitrary margins.
#define FF_GRID_CELLS (PAD_FNUM_X * PAD_FNUM_Y) // 17*17=289, solver's padded grid
#define FF_MAX_PARTICLES 323                    // numX(17)*numY(19) hex-pack count

// Hysteresis thresholds (fractions of particleRestDensity) for update_cell_colors_from_types()
// in flip_fluid.c — research.md Decision 12, reinstated by Decision 15 (real charlieplex
// hardware has no per-LED PWM, so the display is binary again). A cell turns on once density
// climbs above LED_ON_THRESHOLD, and only turns back off once it drops below
// LED_OFF_THRESHOLD; in between, it holds its last state, so sub-cell particle jitter at rest
// can't flip an LED every frame.
#define LED_ON_THRESHOLD 0.5f
#define LED_OFF_THRESHOLD 0.2f

typedef struct {
    float *particlePos;   // x,y positions
    float *s;             // grid solid/fluid flags
    int numParticles;
    int maxParticles;
    int fNumX, fNumY;
    float density;
    float tankWidth;
    float tankHeight;
    float h;              // cell size
    float r;              // particle radius
    float *cellColor;     // add this
} FlipFluid;

// Initialize fluid
void initFlipFluid(FlipFluid *f, int maxParticles);

// Simulate fluid
void simulateFlipFluid(
    FlipFluid *f,
    float dt,
    float gravity_x,
    float gravity_y,
    float flipRatio,
    int numPressureIters,
    int numParticleIters,
    float overRelaxation,
    int compensateDrift,
    int separateParticles
);

#endif
