shamilajeewantha/fluid-pendant/(commit log)

2025-03-26 Refactor index.html to enhance device orientation and motion data display
2025-03-26 Enhance gravity handling in particle simulation and add device motion event support
2025-04-02 Replace index.html with a new implementation for device orientation and motion tracking
2025-04-03 replace modular app with commented files
    [util.c, util.h]
2025-04-03 Add book management system in C; implement book structure, creation, printing, and memory management
2025-04-03 added a timer function
2025-09-14 added basic flip functions to MSwindow. not the algorighm
    [flip_fluid.h, flip_utils.c, main.c, scene.c, scene.h, util.c, util.h]
2025-09-14 Refactor setupScene function to remove unnecessary parameters and implement particle collision handling in FlipFluid class. Update simulation frame rate to 120 FPS and adjust fluid object initializat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
    [flip_utils.c, util.c]
2025-09-14 Add fluid simulation functionality with color mapping and grid updates
    Implemented the simulateFlipFluid function to manage fluid color states in a 10x10 grid. Updated the FlipFluid structure to include a cellColor array and modified the setupScene function to allocate memory for it. Enhanced the simulation process by integrating fluid color updates into the grid representation. Adjusted the main loop to call SimulateFluid for real-time updates.
    [flip_fluid.c, flip_fluid.h, flip_utils.c, main.c, util.c, util.h]
2025-09-22 Enhance fluid simulation with grid allocation, particle integration, and collision handling
    Refactored the simulateFlipFluid function to include dynamic grid allocation based on tank size, improved particle integration with gravity, and added collision handling with tank boundaries. Updated the setupScene function to calculate grid dimensions based on tank size and cell size. Enhanced particle separation and density updates, ensuring accurate fluid behavior in the simulation.
    [flip_fluid.c, flip_utils.c, util.c]
2025-10-20 Initial stm32 project commit with blink, counter variable and serial print
2025-10-21 added SPI, GPIO chip select with 80Mhz without HSE
2025-10-31 added esp32 projects that were used to test adxl362 sensor
2025-11-02 added spi read sensor scripts for esp32
2025-11-02 adxl sensor works over SPI
2025-11-02 sensor measurements are working on stm32
2025-11-08 initial STM32F103C8T6 project.
2025-11-08 Initial led matrix code
2026-05-17 Add initial project files for sample-charlieplexing
    - Created linker script for STM32L432KC (STM32L432KCUX_FLASH.ld) to define memory layout and sections.
    - Added debug launch configuration for sample-charlieplexing project (sample-charlieplexing Debug.launch) to facilitate debugging.
    - Introduced IOC configuration file (sample-charlieplexing.ioc) for MicroXplorer settings and peripheral configuration.
    - Added debug launch configuration for sample-dma project (sample-dma Debug.launch) to support DMA debugging.
2026-06-18 added axelor pcb code
    [axelor.cfg]
2026-06-21 Add fluid simulation implementation with scene management and UI integration
    - Created scene.c and scene.h for managing fluid simulation settings and defaults.
    - Implemented utility functions in util.c and util.h for grid management and simulation control.
    - Developed FlipFluid class in flip.js for fluid dynamics calculations.
    - Added HTML interface in flip_sim.html for user interaction with simulation parameters.
    - Implemented JavaScript logic in script.js to handle gravity adjustments, simulation updates, and dynamic grid rendering.
    - Integrated event listeners for UI elements to control simulation state and parameters.
    [flip_fluid.c, flip_fluid.h, flip_utils.c, main.c, scene.c, scene.h, util.c]
2026-06-21 feat: Add multi-stage fluid simulation project specifications and tasks
    - Created quickstart.md for validation scenarios across stages.
    - Added research.md detailing technical decisions for the fluid simulation.
    - Established spec.md outlining feature specifications and user scenarios.
    - Developed tasks.md listing actionable items for implementing the project in stages.
2026-06-21 Add Docker support and update documentation for fluid simulation projects
    - Created Dockerfiles for both C and JS projects to facilitate reproducible builds and serving.
    - Added .dockerignore files to exclude unnecessary files from Docker context.
    - Updated README.md for the JS project with details on running the prototype directly and via Docker, including controls and display resolution information.
2026-06-21 Refactor display rendering to use continuous brightness from particle density
    - Updated `update_cell_colors_from_types()` in `flip_fluid.c` to render cell brightness directly from `g_particleDensity / g_particleRestDensity`, removing the previous hysteresis logic.
    - Removed hysteresis thresholds (`LED_ON_THRESHOLD`, `LED_OFF_THRESHOLD`) from `flip_fluid.h` and related state management from `flip_fluid.c`.
    - Adjusted `UpdateGridFromFluid()` in `util.c` to store brightness levels as 0-255 instead of binary states.
    - Modified `DrawGrid()` in `util.c` to use the new brightness levels for rendering.
    - Updated JavaScript prototype in `flip.js` to reflect similar changes, ensuring continuous bright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
    [flip_fluid.c, flip_fluid.h, util.c]
2026-06-22 Revert to binary display logic for LED cells; restore hysteresis thresholds
    - Updated `update_cell_colors_from_types()` in `flip_fluid.c` to use hysteresis thresholds (`LED_ON_THRESHOLD` and `LED_OFF_THRESHOLD`) for determining LED states based on `g_particleDensity`, reverting from continuous brightness rendering.
    - Adjusted `grid[][]` in `util.c` to hold binary values (0/1) instead of brightness levels (0-255), aligning with the real charlieplex hardware capabilities.
    - Modified `README.md` files to reflect changes in LED rendering logic and the reinstatement of hysteresis-based decision-making.
    - Updated JavaScript implementation in `flip.js` to match the C code changes, ensuring consiste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
    [flip_fluid.c, flip_fluid.h, util.c]
2026-06-23 Add initial project files for STM32L431CCTx
    - Created linker script (STM32L431CCTX_FLASH.ld) for STM32L4 series with 256KBytes FLASH and 48KBytes RAM.
    - Added configuration file (axelor.cfg) for ST-Link debugging setup.
    - Introduced MicroXplorer configuration settings (axelor.ioc) for STM32L431CCTx, including DMA, GPIO, and USART configurations.
    - Added launch configuration file (axelor.launch) for debugging with STM32CubeIDE, specifying project settings and debug parameters.
    [axelor.cfg]
2026-06-23 Add initial makefile and source files for STM32L4 project
    - Created a new makefile for the STM32L4 project to manage the build process.
    - Added an objects list file to specify the object files for the build.
    - Introduced an objects.mk file to define user objects and libraries.
    - Created a sources.mk file to list source directories and files for the project.
2026-06-25 removed old folders
    [axelor.cfg]
2026-06-25 Refactor code structure for improved readability and maintainability
    [axelor_pcb-BOM.csv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]
2026-06-25 Update README.md for improved clarity and organization; add new images for simulation and prototypes
2026-06-25 Add additional PCB photos to README for enhanced documentation
2026-06-25 Remove width and height attributes from PCB simulation image in README for improved responsiveness
2026-06-25 Update README.md to replace PCB simulation image with GIF for better visualization and adjust image placements for consistency
