shamilajeewantha/fluid-pendant/(notices)

Notices in the files:
stm_project/axelor/Core/Src/main.c:
Copyright (c) 2026 STMicroelectronics.
All rights reserved.
This software is licensed under terms that can be found in the LICENSE file
